drewsum/Audio_Optical_Trigger/hdw/rev_b/Audio_Optical_Trigger/Audio_Optical_Trigger.pdf

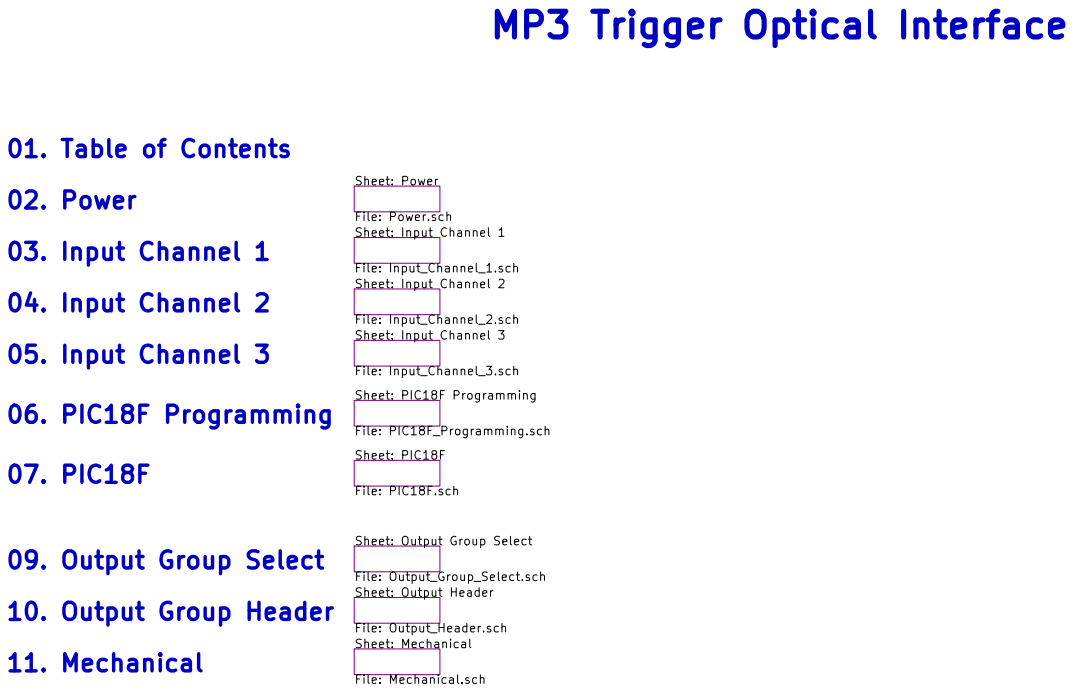
[picture p1: page 1]

File: Output_Header.sch Sheet: Power File: Power.sch Sheet: Mechanical File: Mechanical.sch 07. PIC18F

File: PIC18F.sch Sheet: Output Group Select

File: Audio_Optical_Trigger.sch Sheet: / Drew Maatman

Id: 1/10 Title: MP3 Trigger Optical Interface

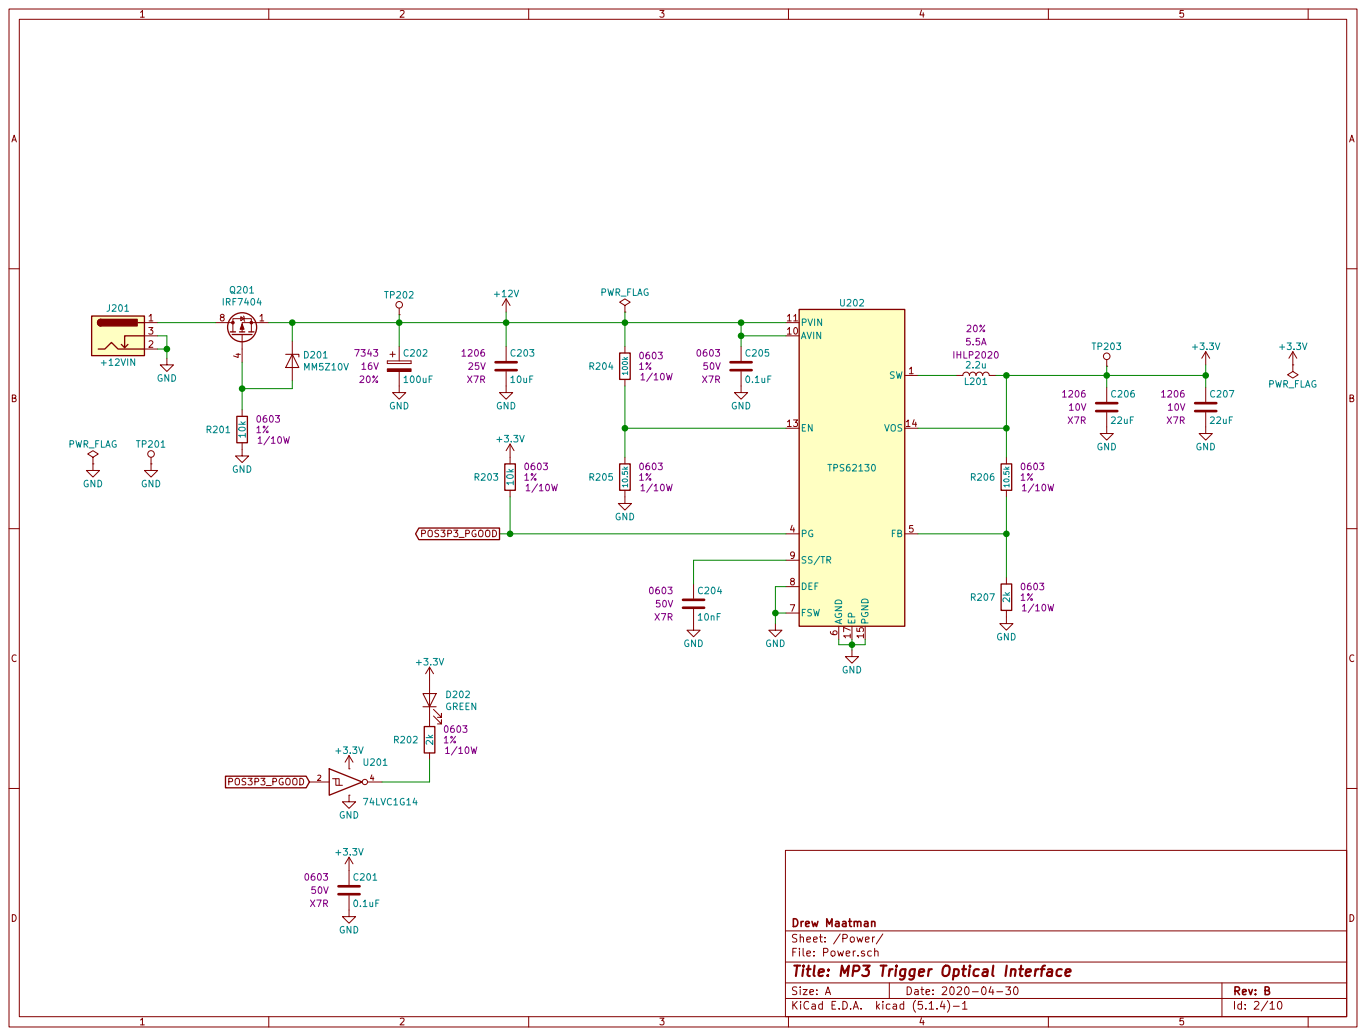
[picture p2: page 2]

6 FSW 7 DEF 8 SS/TR 9 U202 TPS62130 PWR_FLAG

Id: 2/10 Title: MP3 Trigger Optical Interface

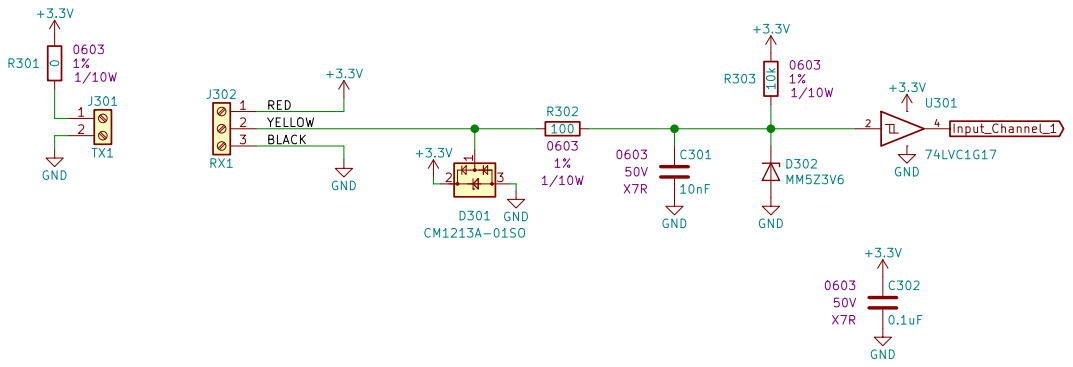
[picture p3: page 3]

File: Input_Channel_1.sch
Id: 3/10 Title: MP3 Trigger Optical Interface

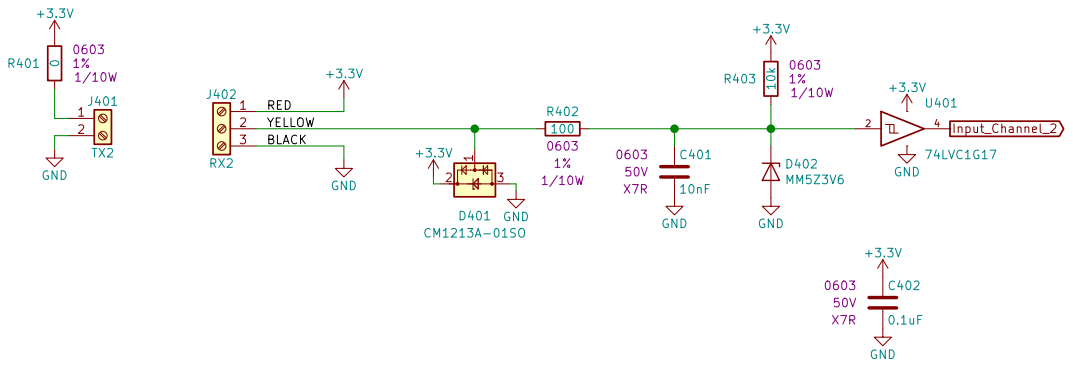
[picture p4: page 4]

File: Input_Channel_2.sch
Id: 4/10 Title: MP3 Trigger Optical Interface

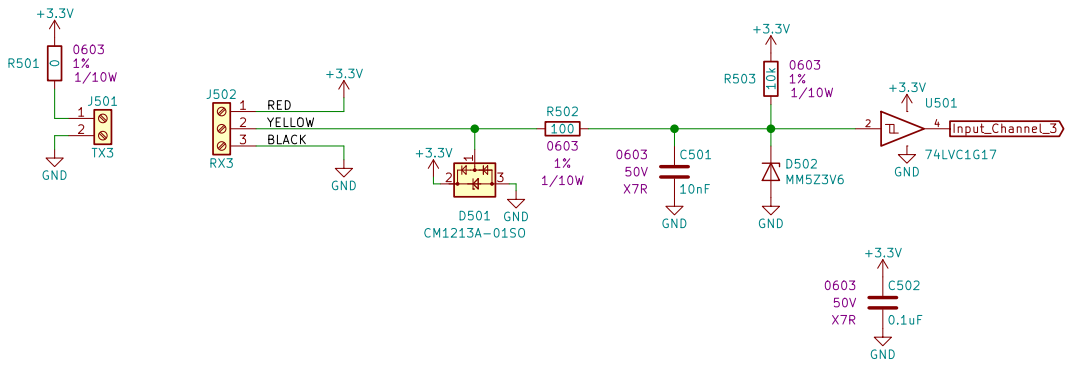
[picture p5: page 5]

File: Input_Channel_3.sch
Id: 5/10 Title: MP3 Trigger Optical Interface

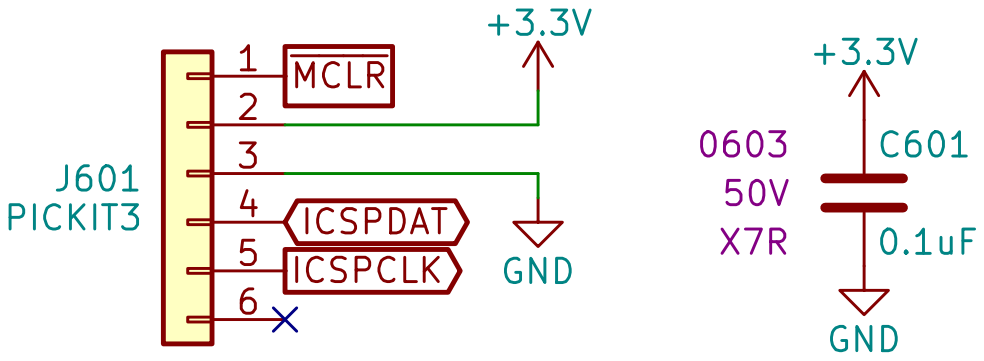
[picture p6: page 6]

Sheet: /PIC18F Programming/ Drew Maatman

File: PIC18F_Programming.sch
Id: 6/10 Title: MP3 Trigger Optical Interface

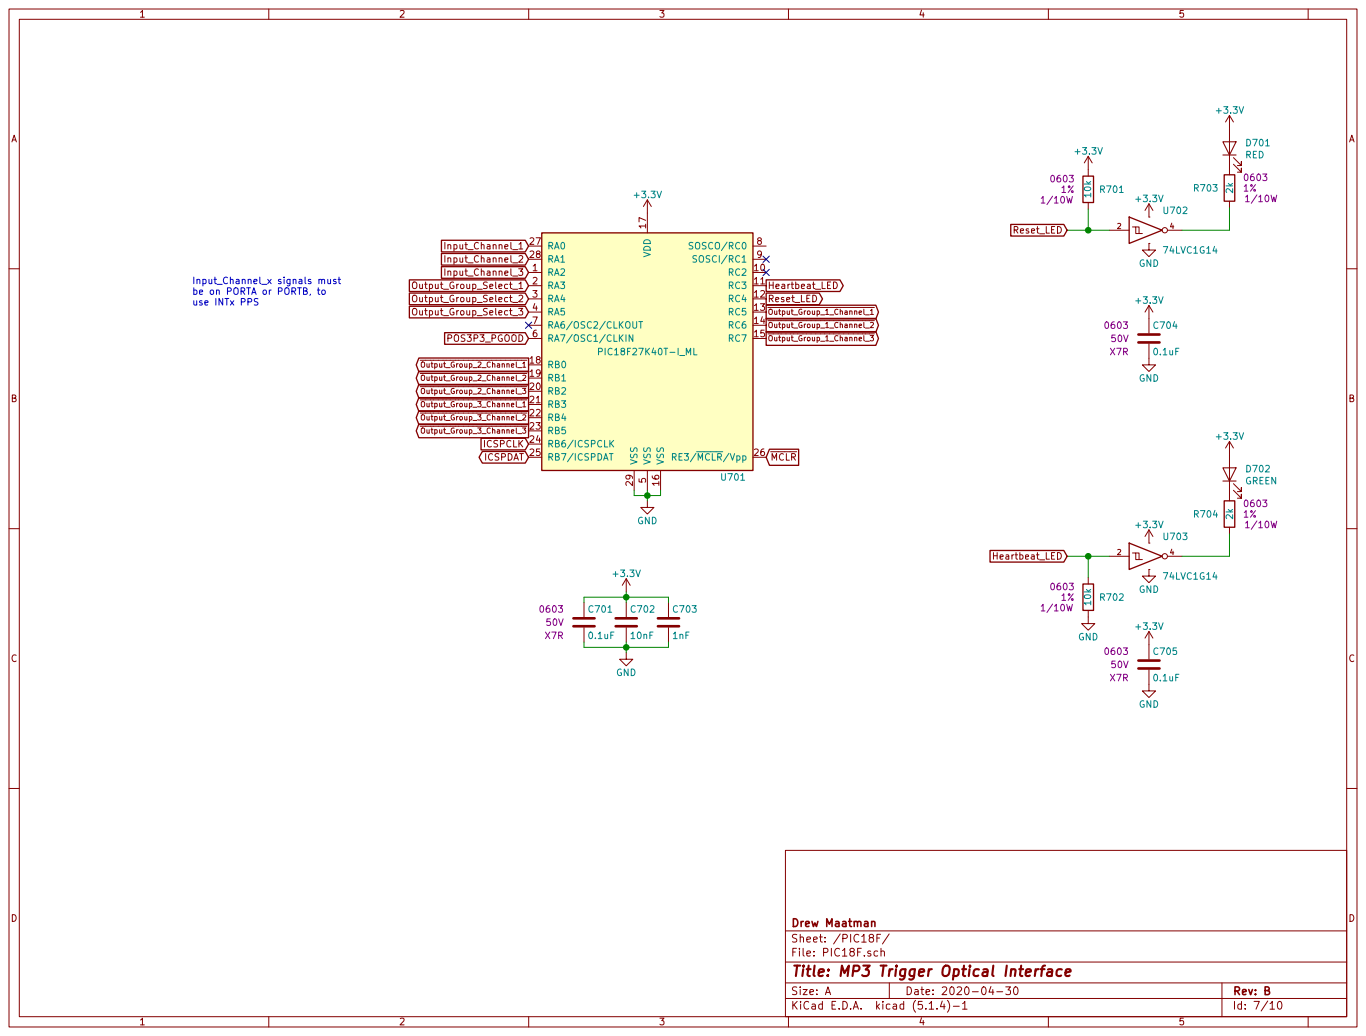
[picture p7: page 7]

5 RA7/OSC1/CLKIN 6 RA6/OSC2/CLKOUT 7 SOSCO/RC0 8 SOSCI/RC1 9 U701 PIC18F27K40T-I_ML C703

Input_Channel_x signals must be on PORTA or PORTB, to

Id: 7/10 Title: MP3 Trigger Optical Interface

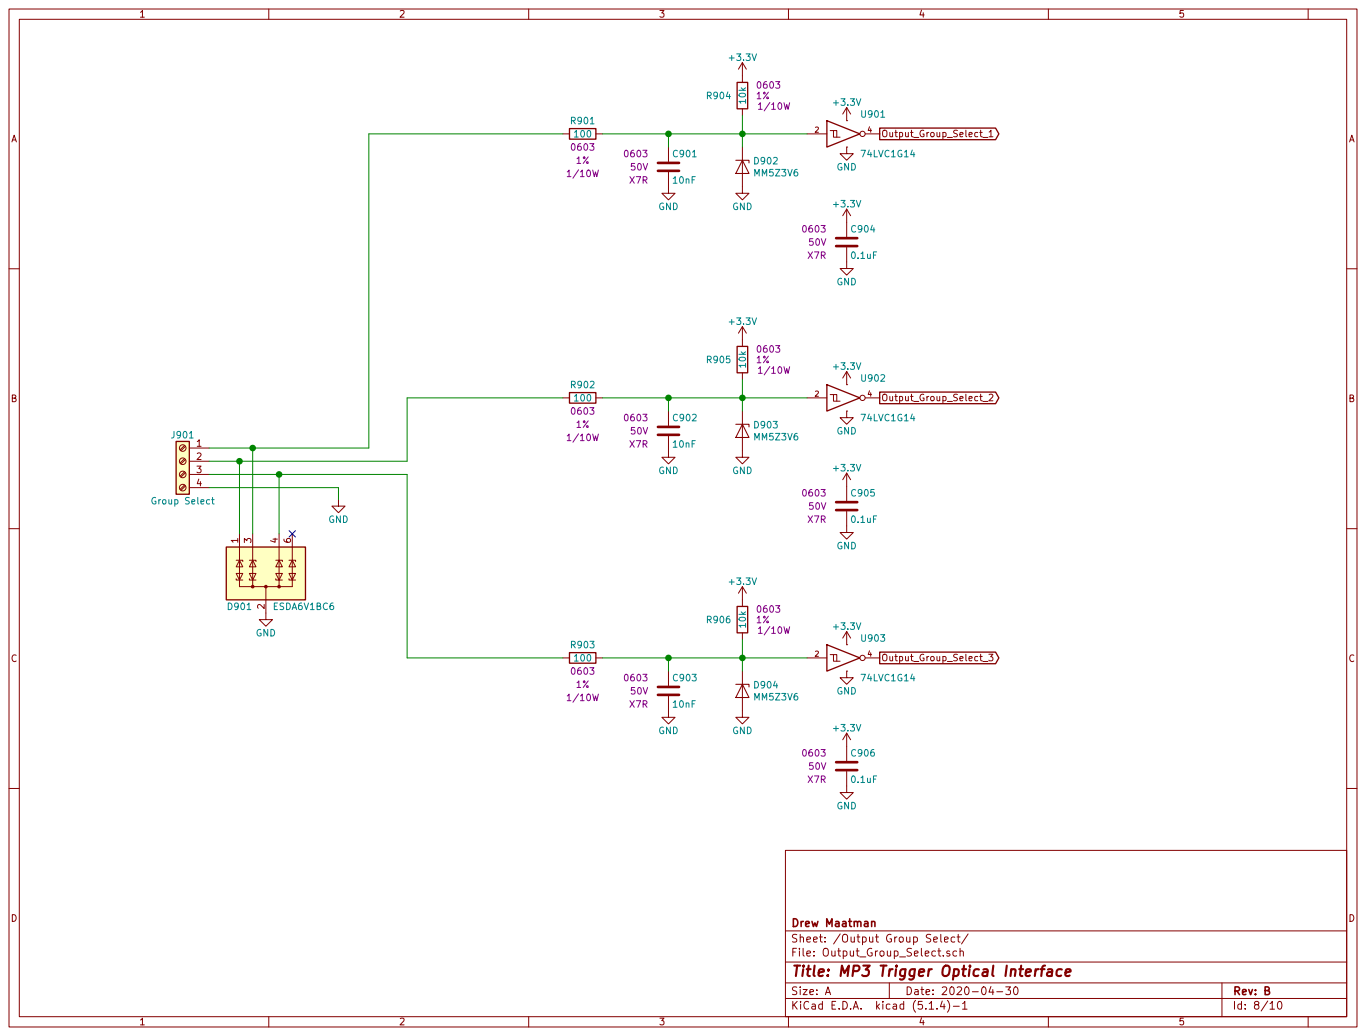
[picture p8: page 8]

File: Output_Group_Select.sch
Id: 8/10 Title: MP3 Trigger Optical Interface

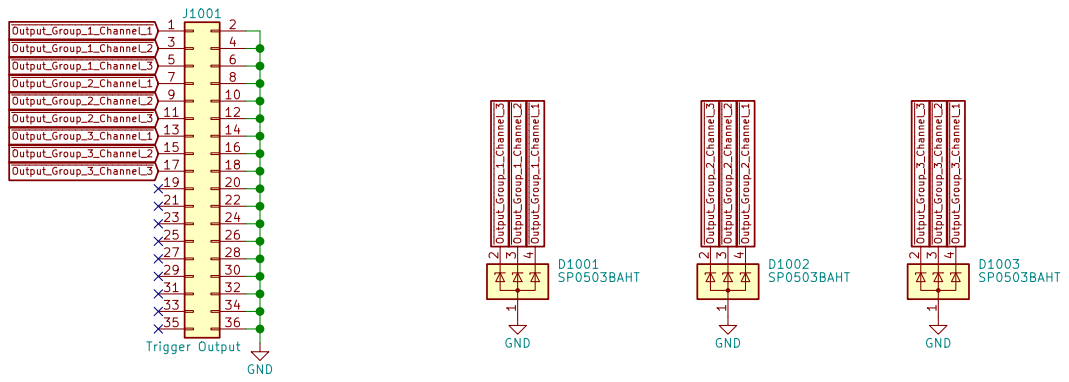
[picture p9: page 9]

File: Output_Header.sch
Id: 9/10 Title: MP3 Trigger Optical Interface

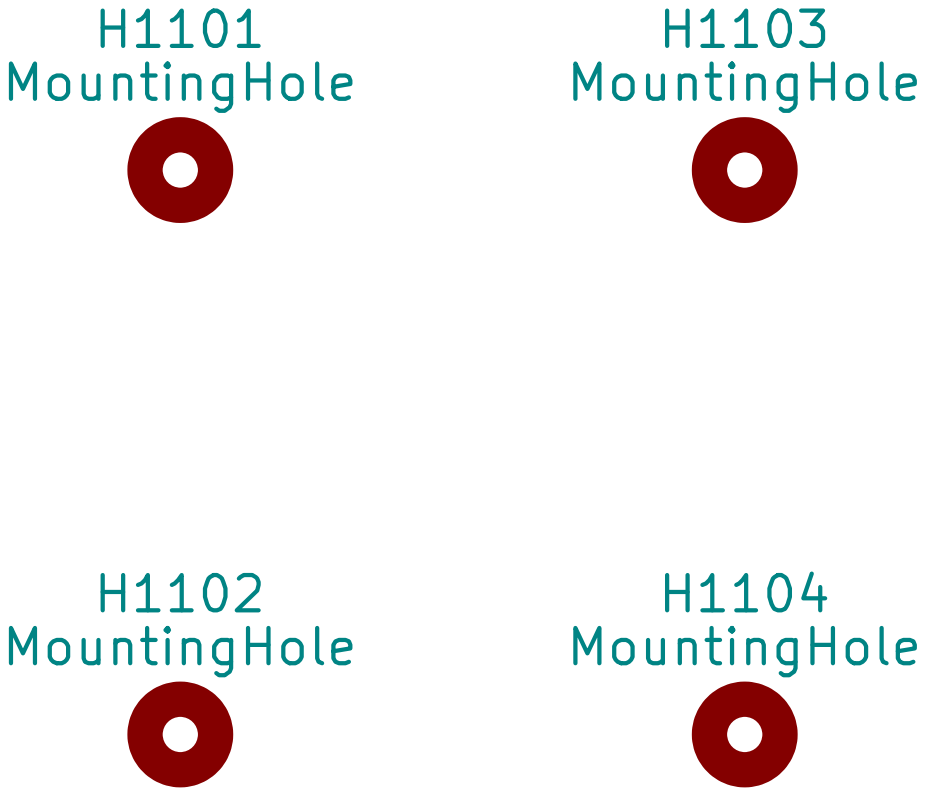
[picture p10: page 10]

File: Mechanical.sch Sheet: /Mechanical/ Drew Maatman

Id: 10/10 Title: MP3 Trigger Optical Interface
