drewsum/Audio_Optical_Trigger/hdw/rev_a/Audio_Optical_Trigger/Audio_Optical_Trigger.pdf

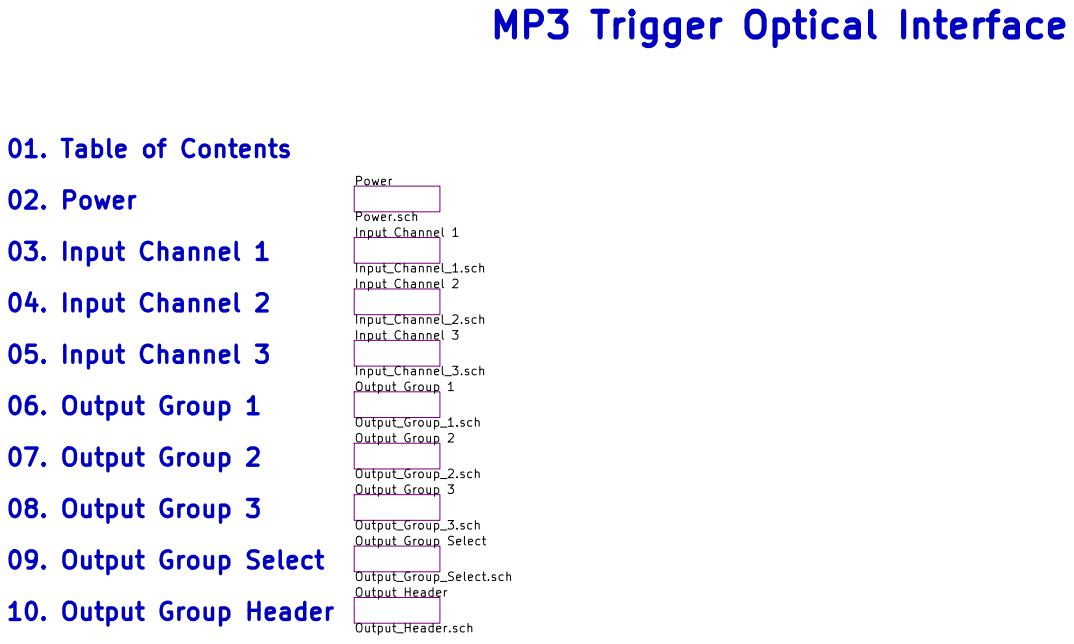
[picture p11: page 1]

File: Audio_Optical_Trigger.sch Sheet: / Drew Maatman

Id: 1/10 Title: MP3 Trigger Optical Interface

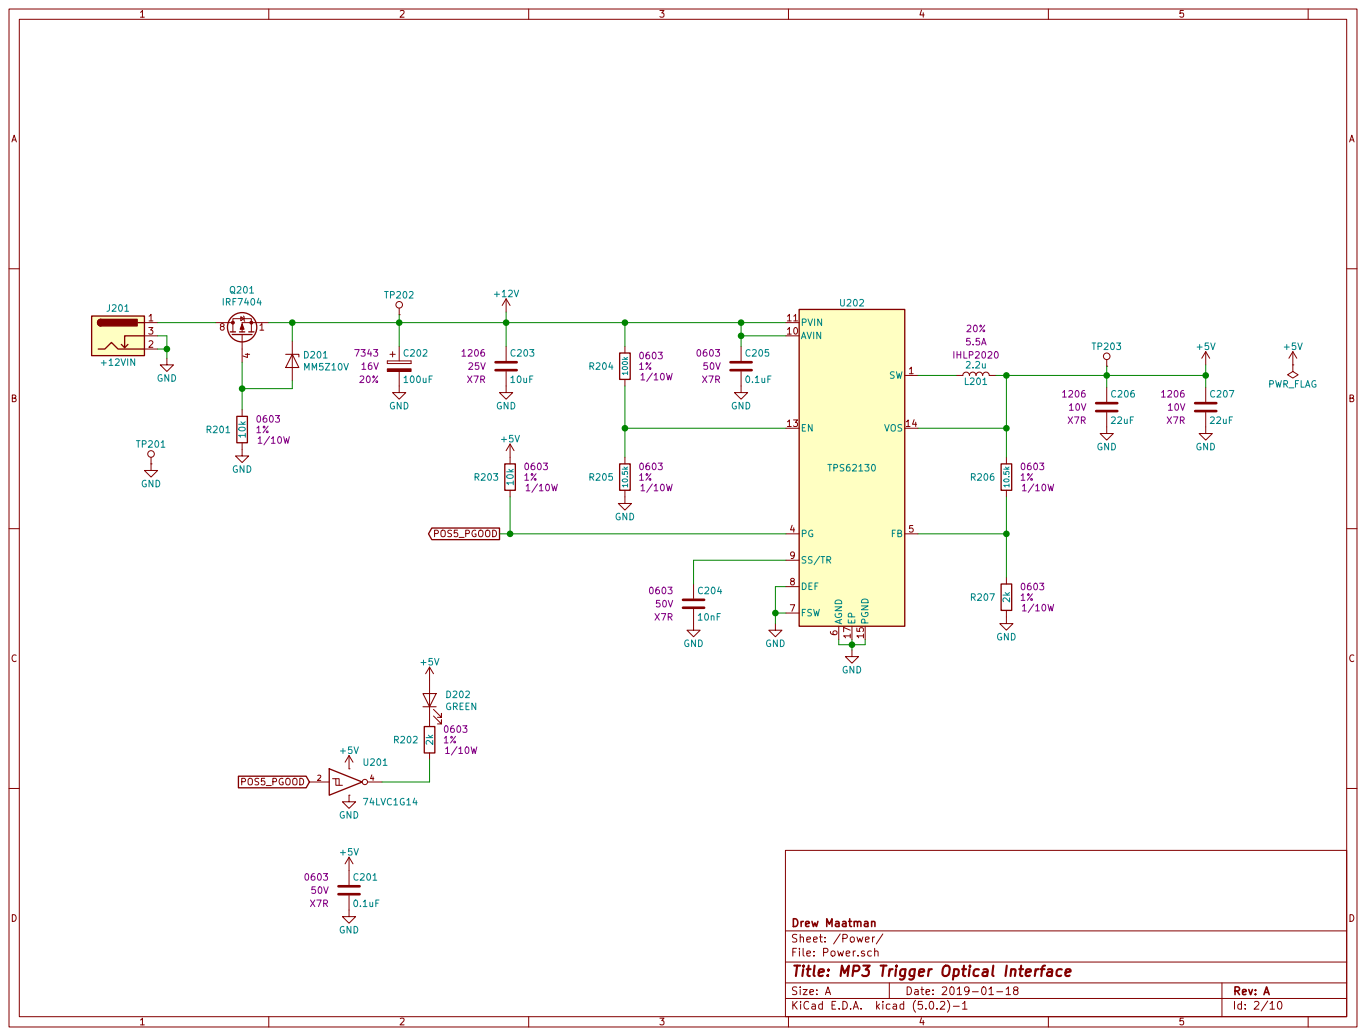
[picture p12: page 2]

6 FSW 7 DEF 8 SS/TR 9 U202 TPS62130 +5V

File: Power.sch Sheet: /Power/ Drew Maatman

Id: 2/10 Title: MP3 Trigger Optical Interface

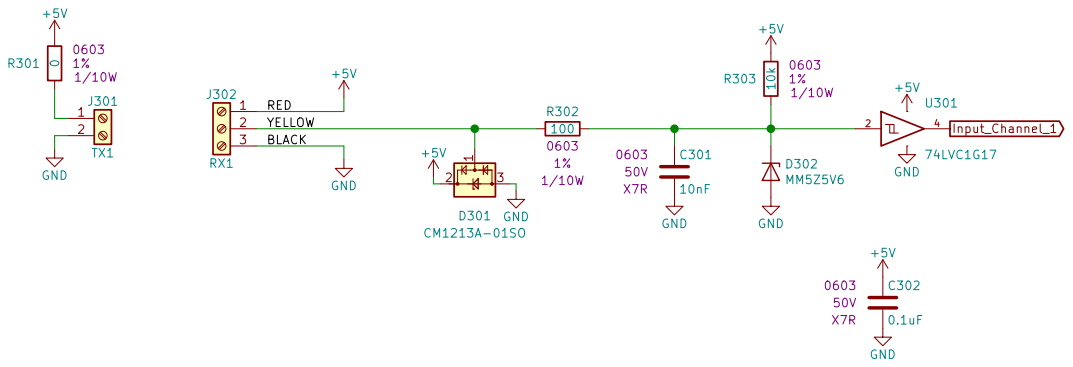
[picture p13: page 3]

Sheet: /Input Channel 1/ Drew Maatman

File: Input_Channel_1.sch
Id: 3/10 Title: MP3 Trigger Optical Interface

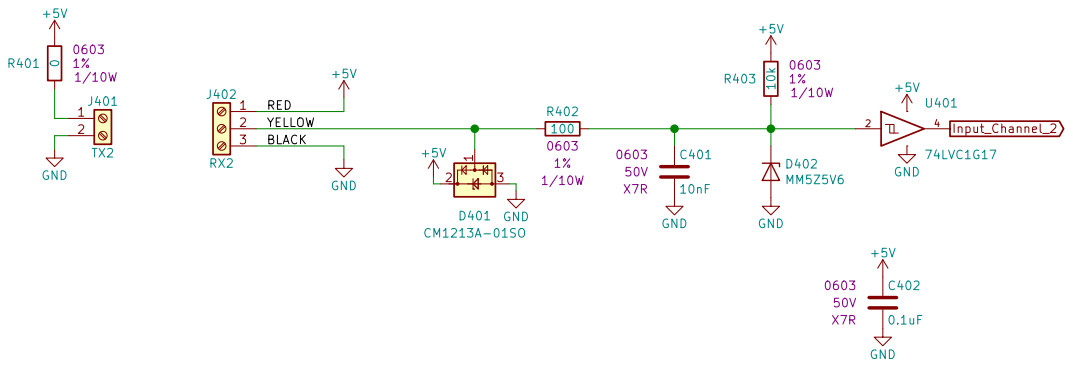
[picture p14: page 4]

Sheet: /Input Channel 2/ Drew Maatman

File: Input_Channel_2.sch
Id: 4/10 Title: MP3 Trigger Optical Interface

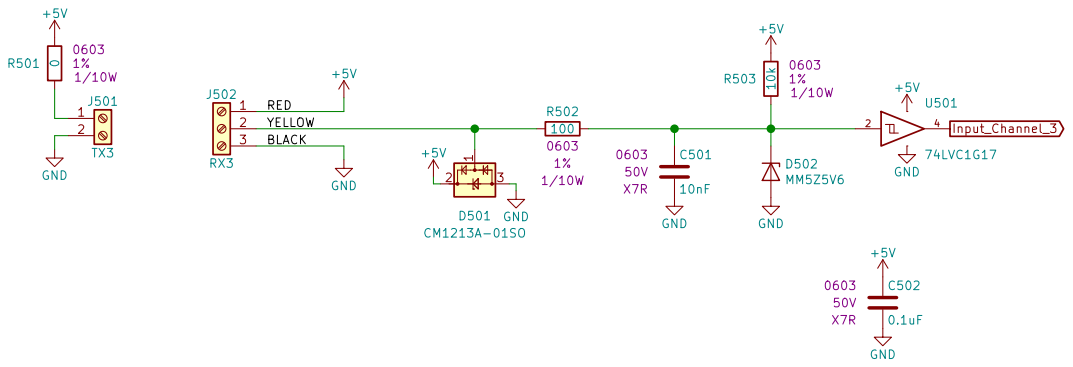
[picture p15: page 5]

Sheet: /Input Channel 3/ Drew Maatman

File: Input_Channel_3.sch
Id: 5/10 Title: MP3 Trigger Optical Interface

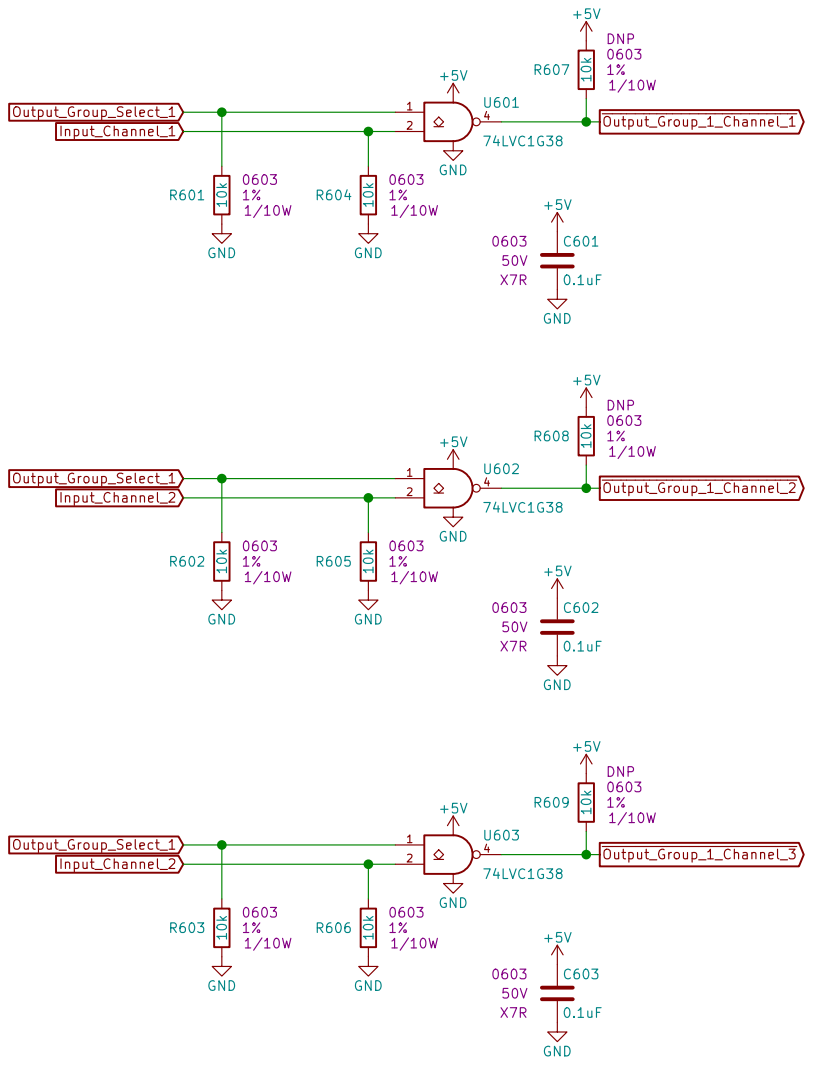
[picture p16: page 6]

Sheet: /Output Group 1/ Drew Maatman

File: Output_Group_1.sch
Id: 6/10 Title: MP3 Trigger Optical Interface

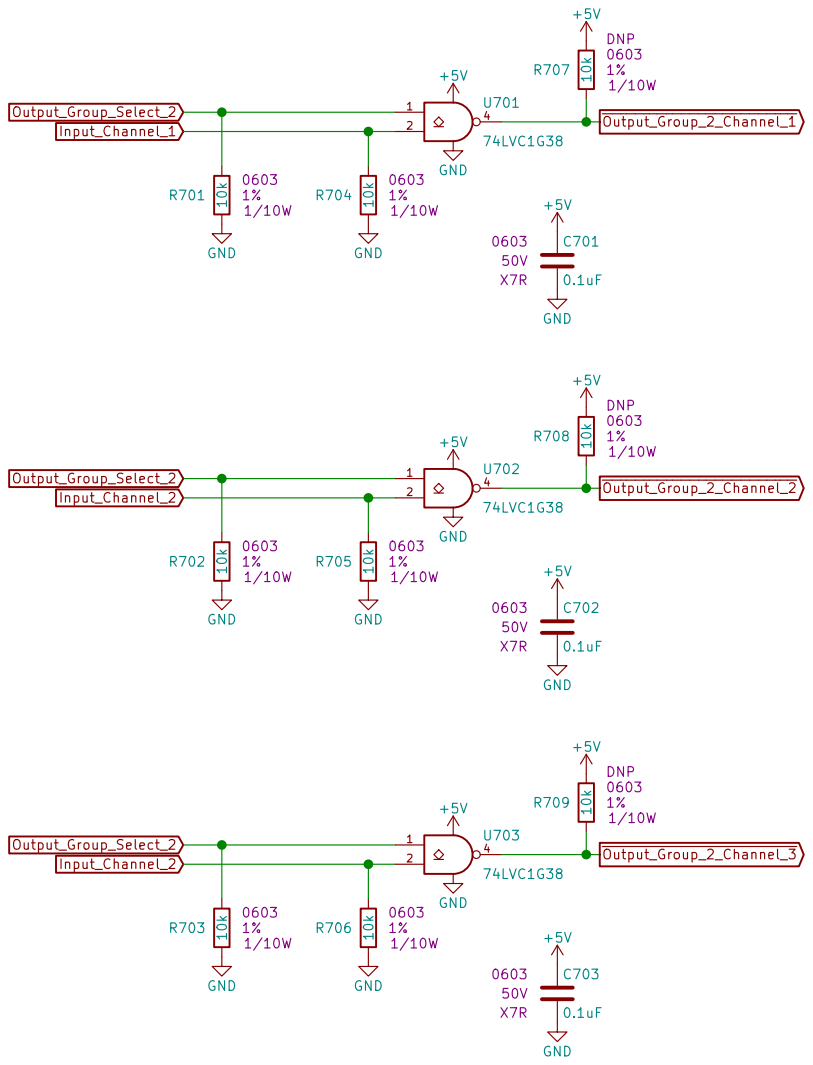
[picture p17: page 7]

Sheet: /Output Group 2/ Drew Maatman

File: Output_Group_2.sch
Id: 7/10 Title: MP3 Trigger Optical Interface

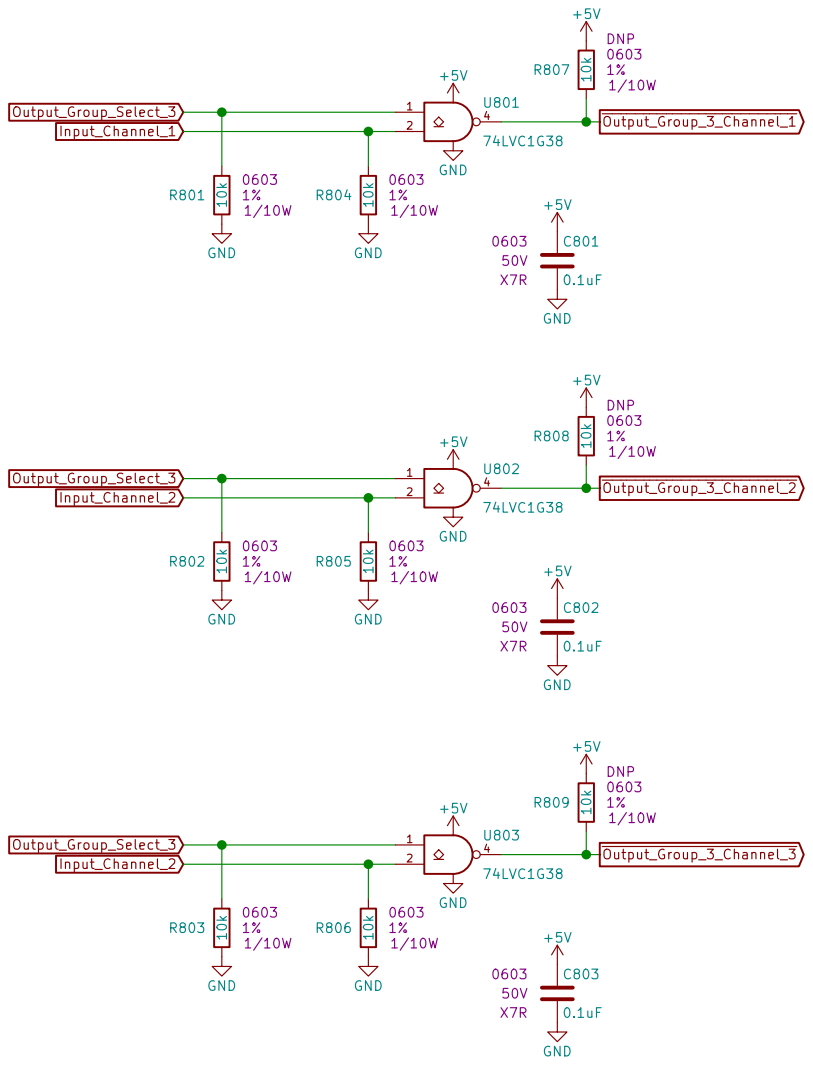
[picture p18: page 8]

Sheet: /Output Group 3/ Drew Maatman

File: Output_Group_3.sch
Id: 8/10 Title: MP3 Trigger Optical Interface

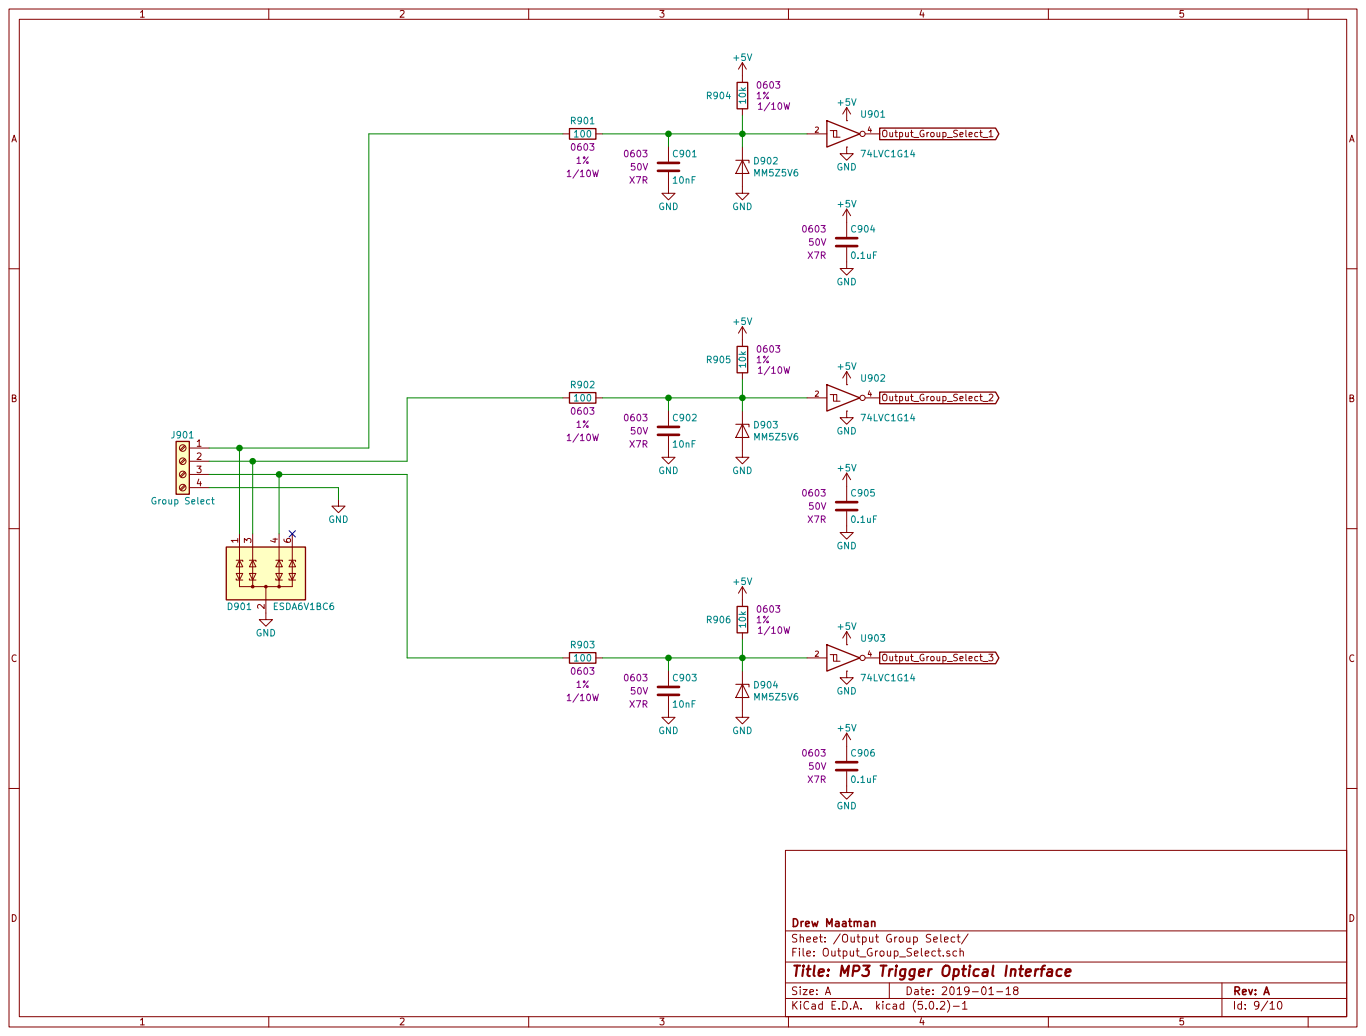
[picture p19: page 9]

Sheet: /Output Group Select/ Drew Maatman

File: Output_Group_Select.sch
Id: 9/10 Title: MP3 Trigger Optical Interface

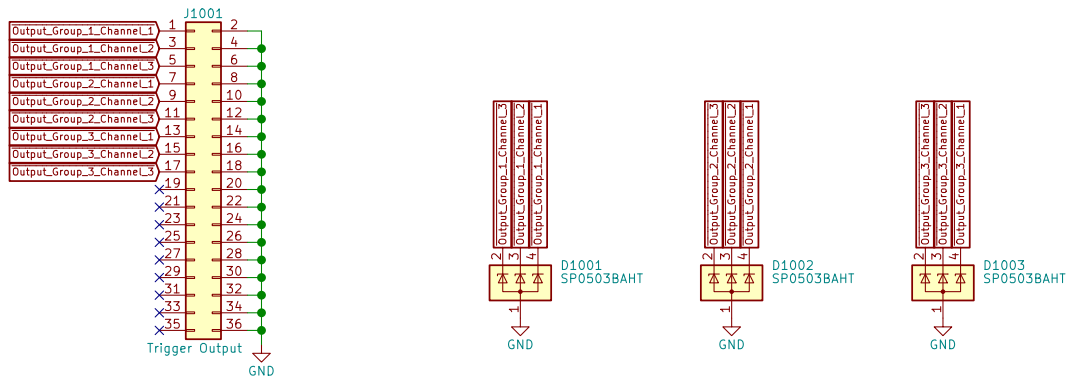
[picture p20: page 10]

Sheet: /Output Header/ Drew Maatman

File: Output_Header.sch
Id: 10/10 Title: MP3 Trigger Optical Interface
