drewsum/Audio_Optical_Trigger/hdw/rev_b/Audio_Optical_Trigger/Audio_Optical_Trigger.kicad_pcb

## KiCad design hdw/rev_b/Audio_Optical_Trigger/Audio_Optical_Trigger.kicad_pcb (2020-05-02)

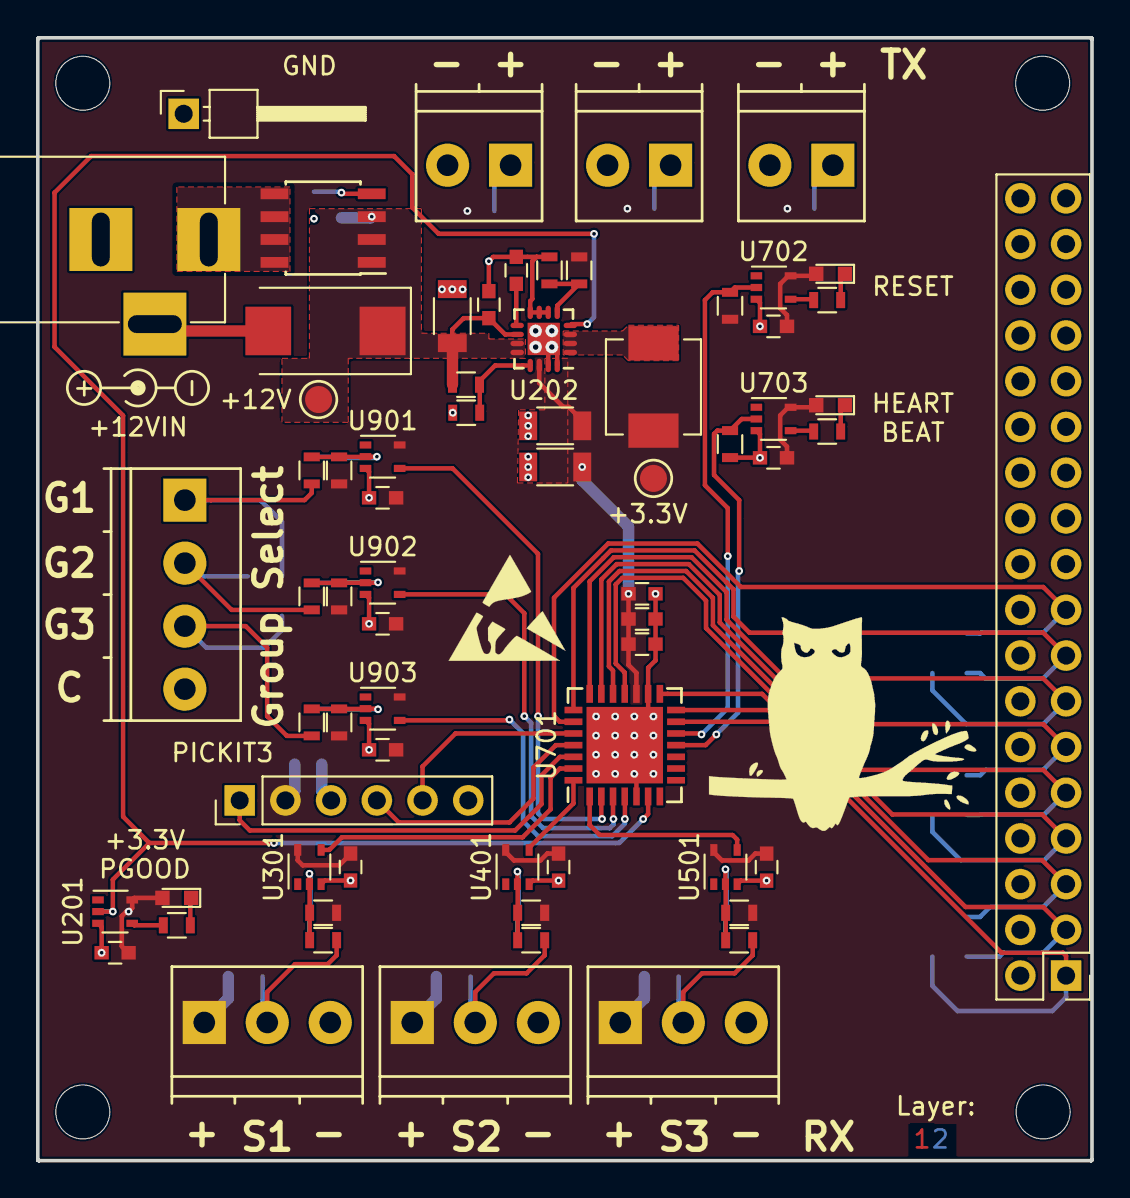
[picture p21: board Audio_Optical_Trigger.kicad_pcb from above]

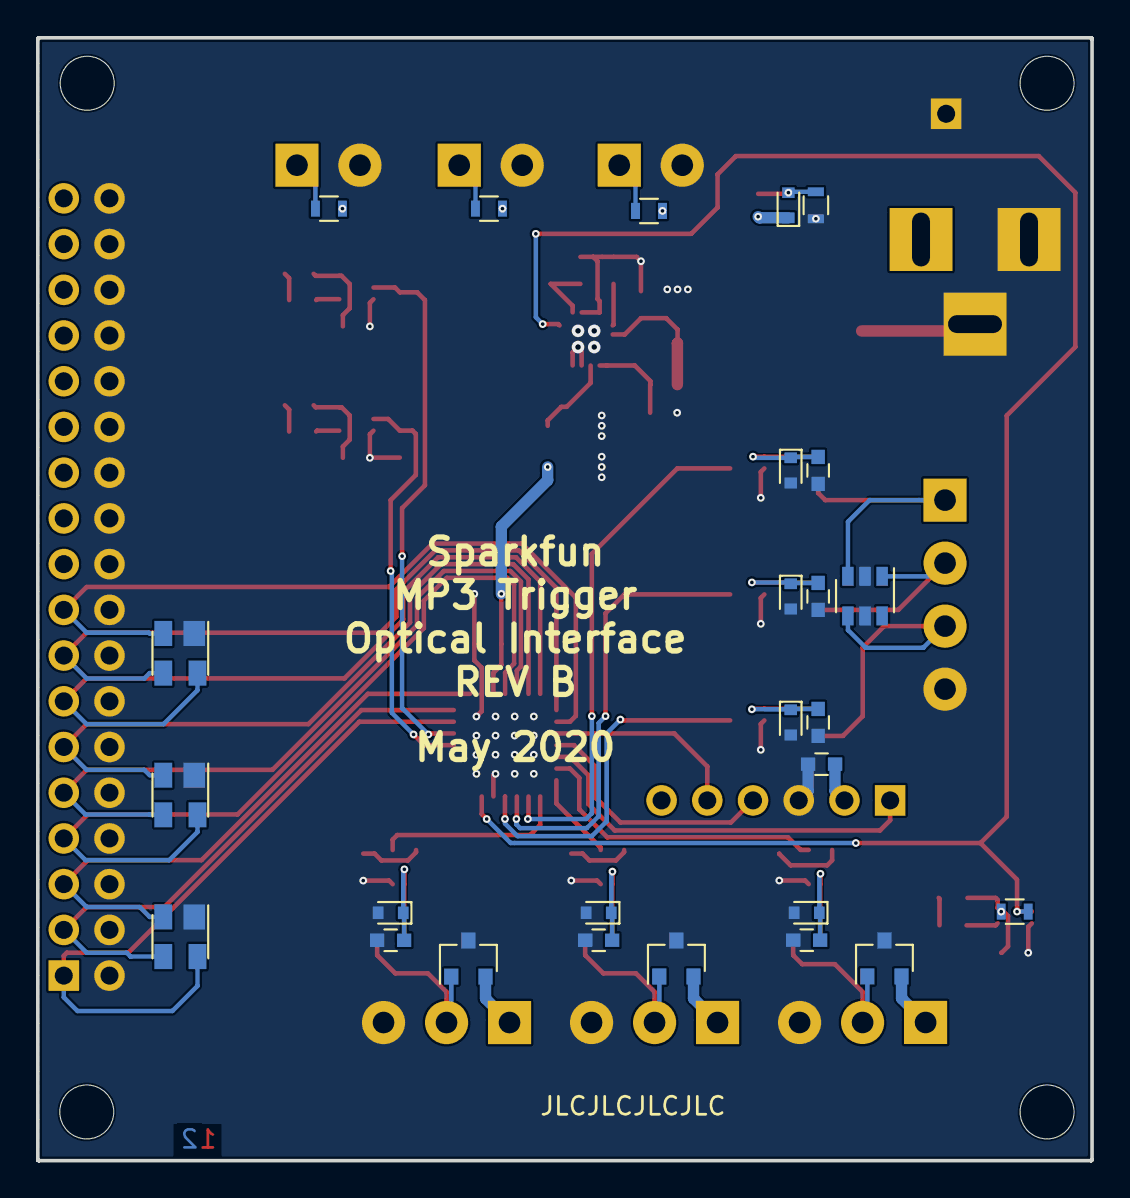
[picture p22: board Audio_Optical_Trigger.kicad_pcb from below]

Board: 2 copper layers, 58.6 x 62.4 mm, 98 parts (30 on the bottom side), 51 nets.

Parts:
C201, C205, C302, C402, C502, C601, C701, C704, C705, C904, C905, C906: 0.1uF; C_0603
C202: 100uF; CP_Tantalum_Case-D_EIA-7343-31_Reflow
C203: 10uF; C_1206
C204, C301, C401, C501, C702, C901, C902, C903: 10nF; C_0603
C206, C207: 22uF; C_1206
C703: 1nF; C_0603
D201: MM5Z10V; D_SOD-523
D202, D702: GREEN; LED_0603
D301, D401, D501: CM1213A-01SO; SOT-23
D302, D402, D502, D902, D903, D904: MM5Z3V6; D_SOD-523
D701: RED; LED_0603
D901: ESDA6V1BC6; SOT-23-6
D1001, D1002, D1003: SP0503BAHT; SOT-143
H1101, H1102, H1103, H1104: MountingHole; MountingHole_3mm
J201: +12VIN; BARREL_JACK
J301: TX1; TerminalBlock_Phoenix_PT-3.5mm_2pol
J302: RX1; TerminalBlock_Phoenix_PT-3.5mm_3pol
J401: TX2; TerminalBlock_Phoenix_PT-3.5mm_2pol
J402: RX2; TerminalBlock_Phoenix_PT-3.5mm_3pol
J501: TX3; TerminalBlock_Phoenix_PT-3.5mm_2pol
J502: RX3; TerminalBlock_Phoenix_PT-3.5mm_3pol
J601: PICKIT3; PinHeader_1x06_P2.54mm_Vertical
J901: Group Select; TerminalBlock_Phoenix_PT-3.5mm_4pol
J1001: Trigger Output; Pin_Header_Straight_2x18_Pitch2.54mm
L201: 2.2u; L_Vishay_IHLP-2020
Q201: IRF7404; SOIC-8_3.9x4.9mm_Pitch1.27mm
R201, R203, R303, R403, R503, R701, R702, R904, R905, R906: 10k; R_0603
R202, R207, R703, R704: 2k; R_0603
R204: 100k; R_0603
R205, R206: 10.5k; R_0603
R301, R401, R501: 0; R_0603
R302, R402, R502, R901, R902, R903: 100; R_0603
TP201: TP; Pin_Header_Angled_1x01_Pitch2.54mm
TP202, TP203: TP; Test_Point
U201, U702, U703, U901, U902, U903: 74LVC1G14; SOT-353_SC-70-5
U202: TPS62130; QFN-16-1EP_3x3mm_Pitch0.5mm
U301, U401, U501: 74LVC1G17; SOT-353_SC-70-5
U701: PIC18F27K40T-I_ML; QFN-28-1EP_6x6mm_Pitch0.65mm

Connections:
+3V3: C201.1, C206.1, C207.1, C302.1, C402.1, C502.1, C601.1, C701.1, C702.1, C703.1, C704.1, C705.1, C904.1, C905.1, C906.1, D202.2, D301.2, D401.2, D501.2, D701.2, D702.2, J302.1, J402.1, J502.1, J601.2, L201.2, R203.1, R206.1, R301.1, R303.1, R401.1, R403.1, R501.1, R503.1, R701.1, R904.1, R905.1, R906.1, TP203.1, U201.5, U202.14, U301.5, U401.5, U501.5, U701.17, U702.5, U703.5, U901.5, U902.5, U903.5
+12V: C202.1, C203.1, C205.1, D201.1, Q201.1, Q201.2, Q201.3, R204.1, TP202.1, U202.10, U202.11, U202.12
/Input Channel 1/YELLOW: D301.1, J302.2, R302.2
/Input Channel 2/YELLOW: D401.1, J402.2, R402.2
/Input Channel 3/YELLOW: D501.1, J502.2, R502.2
GND: C201.2, C202.2, C203.2, C204.2, C205.2, C206.2, C207.2, C301.2, C302.2, C401.2, C402.2, C501.2, C502.2, C601.2, C701.2, C702.2, C703.2, C704.2, C705.2, C901.2, C902.2, C903.2, C904.2, C905.2, C906.2, D301.3, D302.2, D401.3, D402.2, D501.3, D502.2, D901.2, D901.5, D902.2, D903.2, D904.2, D1001.1, D1002.1, D1003.1, J201.2, J201.3, J301.2, J302.3, J401.2, J402.3, J501.2, J502.3, J601.3, J901.4, J1001.2, J1001.4, J1001.6, J1001.8, J1001.10, J1001.12, J1001.14, J1001.16, J1001.18, J1001.20, J1001.22, J1001.24, J1001.26, J1001.28, J1001.30, J1001.32, J1001.34, J1001.36, R201.2, R205.2, R207.2, R702.2, TP201.1, U201.3, U202.6, U202.7, U202.8, U202.15, U202.16, U202.17, U301.3, U401.3, U501.3, U701.5, U701.16, U701.29, U702.3, U703.3, U901.3, U902.3, U903.3
Heartbeat_LED: R702.1, U701.11, U703.2
ICSPCLK: J601.5, U701.24
ICSPDAT: J601.4, U701.25
Input_Channel_1: U301.4, U701.27
Input_Channel_2: U401.4, U701.28
Input_Channel_3: U501.4, U701.1
unnamed: C204.1, U202.9
unnamed: C301.1, D302.1, R302.1, R303.2, U301.2
unnamed: C401.1, D402.1, R402.1, R403.2, U401.2
unnamed: C501.1, D502.1, R502.1, R503.2, U501.2
unnamed: C901.1, D902.1, R901.1, R904.2, U901.2
unnamed: C902.1, D903.1, R902.1, R905.2, U902.2
unnamed: C903.1, D904.1, R903.1, R906.2, U903.2
unnamed: D201.2, Q201.4, R201.1
unnamed: D202.1, R202.1
unnamed: D701.1, R703.1
unnamed: D702.1, R704.1
unnamed: D901.1, J901.2, R902.2
unnamed: D901.3, J901.1, R901.2
unnamed: D901.4, J901.3, R903.2
unnamed: J201.1, Q201.5, Q201.6, Q201.7, Q201.8
unnamed: J301.1, R301.2
unnamed: J401.1, R401.2
unnamed: J501.1, R501.2
unnamed: L201.1, U202.1, U202.2, U202.3
unnamed: R202.2, U201.4
unnamed: R204.2, R205.1, U202.13
unnamed: R206.2, R207.1, U202.5
unnamed: R703.2, U702.4
unnamed: R704.2, U703.4
Output_Group_Select_1: U701.2, U901.4
Output_Group_Select_2: U701.3, U902.4
Output_Group_Select_3: U701.4, U903.4
POS3P3_PGOOD: R203.2, U201.2, U202.4, U701.6
Reset_LED: R701.2, U701.12, U702.2
~MCLR: J601.1, U701.26
~Output_Group_1_Channel_1: D1001.4, J1001.1, U701.13
~Output_Group_1_Channel_2: D1001.3, J1001.3, U701.14
~Output_Group_1_Channel_3: D1001.2, J1001.5, U701.15
~Output_Group_2_Channel_1: D1002.4, J1001.7, U701.18
~Output_Group_2_Channel_2: D1002.3, J1001.9, U701.19
~Output_Group_2_Channel_3: D1002.2, J1001.11, U701.20
~Output_Group_3_Channel_1: D1003.4, J1001.13, U701.21
~Output_Group_3_Channel_2: D1003.3, J1001.15, U701.22
~Output_Group_3_Channel_3: D1003.2, J1001.17, U701.23
