drewsum/Audio_Optical_Trigger/(commit log)

2019-01-10 Started messing around
    [Audio_Optical_Trigger.kicad_pcb, Audio_Optical_Trigger.sch, Input_Channel_1.sch, Output_Channel_1.sch, Output_Group_Select.sch, Output_Header.sch, Power.sch]
2019-01-10 Removed unneeded output gate
    [Audio_Optical_Trigger.sch, Input_Channel_1.sch, Output_Channel_1.sch, Output_Group_Select.sch, Output_Header.sch, Power.sch]
2019-01-18 Basically finished schematic
    [Audio_Optical_Trigger.sch, Input_Channel_2.sch, Input_Channel_3.sch, Output_Channel_1.sch, Output_Group_1.sch, Output_Group_2.sch, Output_Group_3.sch, Output_Group_Select.sch]
2019-01-19 Reordered pages, added footprints
    [Audio_Optical_Trigger.sch, Input_Channel_1.sch, Input_Channel_2.sch, Input_Channel_3.sch, Output_Group_1.sch, Output_Group_2.sch, Output_Group_3.sch, Output_Group_Select.sch]
2019-01-19 Finished schematic
    [Audio_Optical_Trigger.sch, Input_Channel_1.sch, Input_Channel_2.sch, Input_Channel_3.sch, Output_Group_1.sch, Output_Group_2.sch, Output_Group_3.sch, Output_Group_Select.sch]
2019-01-19 Added BOM
    [Audio_Optical_Trigger_bom_A.xlsx]
2019-01-19 Revised BOM
    [Audio_Optical_Trigger_bom_A.xlsx, Input_Channel_1.sch, Input_Channel_2.sch, Input_Channel_3.sch, Output_Group_Select.sch]
2019-01-19 Pulled parts into PCB
    [Audio_Optical_Trigger.kicad_pcb]
2019-01-19 Fixed diode footprint issue
    [Audio_Optical_Trigger.kicad_pcb, Input_Channel_1.sch, Input_Channel_2.sch, Input_Channel_3.sch, Power.sch]
2019-01-19 Rewired a few nets, placed some parts
    [Audio_Optical_Trigger.kicad_pcb, Output_Header.sch]
2019-01-19 Determined PCB shape
    [Audio_Optical_Trigger.kicad_pcb, Audio_Optical_Trigger.sch, Input_Channel_1.sch, Input_Channel_2.sch, Input_Channel_3.sch, Mechanical.sch, Output_Group_1.sch, Output_Group_2.sch]
2019-01-20 Routed board in one go
    [Audio_Optical_Trigger.kicad_pcb]
2019-01-21 Adjusted routing, design rules
    [Audio_Optical_Trigger.kicad_pcb]
2020-05-01 Rev B schematic
    [Audio_Optical_Trigger.kicad_pcb, Audio_Optical_Trigger.sch, Audio_Optical_Trigger_bom_A.csv, Audio_Optical_Trigger_bom_A.xlsx, Input_Channel_1.sch, Input_Channel_2.sch, Input_Channel_3.sch, Mechanical.sch]
2020-05-02 routed rev b board, created BOM, generated gerbers
    [Audio_Optical_Trigger-B_Cu.gbr, Audio_Optical_Trigger-B_Mask.gbr, Audio_Optical_Trigger-B_SilkS.gbr, Audio_Optical_Trigger-Edge_Cuts.gbr, Audio_Optical_Trigger-F_Cu.gbr, Audio_Optical_Trigger-F_Mask.gbr, Audio_Optical_Trigger-F_SilkS.gbr, Audio_Optical_Trigger-NPTH.drl]
2020-05-19 Got sfw working without timers
2020-05-19 Got timer based implementation working
